belenmansilla/electronic-sandro/(commit log)

2026-07-11 Commit inicial: Código base de Sandro en ESP32
2026-07-11 agrego carpeta con el codigo depatrullaje
2026-07-11 modificacion de readme.md
2026-07-11 restructuracion de carpetas y se agrega documentacion
2026-07-31 archivo de sensores de linea
2026-08-04 combate cambio de pin 33 a 32 porque se quemo
2026-08-08 Modificacion readme y carpetas. Se agrega ultima version de combate_v3 para Asimov y se modifica nombre los otros archivos combate
2026-08-27 se agrega nueva funcion de combate y control remoto
2026-09-29 Agrega código de combate v5
